nemanja-krsman/ChickenCoop_SmartLight/doc/HardwareOverview.md

# Smart Chicken Coop Lighting System — Hardware Overview

This document describes the system architecture, hardware circuits, prototype
components, and installation shown in the project README.

## System Architecture

The following block diagram illustrates the overall system architecture.

System architecture block diagram

The system consists of four primary functional blocks:

- **Real-Time Clock (RTC):** Maintains the time used for scheduled lighting operations, including during power outages when supported by its backup battery.
- **ESP32 Microcontroller:** Executes the scheduling logic, processes zero-cross detection signals, and controls the timing of triac firing pulses.
- **Zero-Cross Detection Circuit:** Provides synchronization signals corresponding to the AC voltage zero crossings, allowing the ESP32 to synchronize its control logic with the mains waveform.
- **Dual-Channel AC Dimmer:** Independently controls the brightness of two connected lighting loads through phase-angle control.

## Hardware Design & Circuit Breakdown

### 1. Zero-Cross Detection Circuit

Zero-cross detection circuit schematic

The zero-cross detection circuit synchronizes the ESP32 with the AC mains waveform.

- **Rectification:** A DF1504S-T bridge rectifier processes the AC input for the detection circuit.
- **Optoisolation:** A 4N25 optocoupler provides electrical isolation between the mains-side detection circuit and the low-voltage control circuitry. Two 120 kΩ resistors connected in parallel limit the current through the optocoupler's input LED.
- **Signal generation:** The optocoupler's output transistor switches according to the detected mains waveform. The ESP32 reads the resulting signal through a GPIO input configured for interrupt-based synchronization.

The firmware uses these synchronization events to determine when to trigger the triacs during each AC half-cycle. The resulting firing delay determines the amount of power delivered to each compatible lighting load.

### 2. Real-Time Clock (RTC) — DS1307

DS1307 real-time clock schematic

The DS1307 RTC maintains the system time independently of the ESP32's reset state.

- **Timekeeping and backup:** A crystal oscillator provides the RTC's time base, while a backup battery (BT1) helps maintain timekeeping when the main supply is unavailable.
- **I²C communication:** The RTC communicates with the ESP32 over the SDA and SCL lines.
- **Voltage considerations:** The DS1307 normally operates from a 5 V supply. The I²C pull-up arrangement must be compatible with both the RTC and the ESP32's 3.3 V GPIOs. The ESP32 must never be exposed to an I²C pull-up voltage that exceeds its GPIO ratings.

### 3. Dual-Channel AC Dimmer Circuit

Dual-channel AC dimmer schematic

The dimmer circuit provides independent brightness control for two AC lighting loads.

- **Triac triggering and optoisolation:** Each channel uses a MOC3021-series optotriac driver and a BTA16-600B power triac. The optotriac driver provides an isolation barrier between the low-voltage control circuitry and the mains-side triac control circuit.
- **Phase-angle control:** After detecting an AC zero crossing, the ESP32 waits for a calculated delay before generating a triac firing pulse. Adjusting this delay changes the portion of each AC half-cycle delivered to the load, allowing the controller to regulate brightness.
- **Transient suppression:** An RC snubber network, consisting of the corresponding resistor and capacitor across each triac, helps limit voltage transients and unwanted rapid voltage changes. Its component values and suitability depend on the load and must be validated for the intended application.

## Prototyping & Installation

A custom PCB is not strictly necessary to experiment with the system's control logic. A prototype can also be assembled using suitable off-the-shelf modules.

### AC Dimmer Module

A compatible RobotDyn AC Light Dimmer Module can be used for prototyping, provided its interface, channel count, load compatibility, and electrical ratings match the application.

AC dimmer module

### RTC Module

A DS1307-based I²C real-time clock module with a backup battery can provide the timekeeping functionality.

RTC module

### Microcontroller

A standard ESP32 development board can be used to run the firmware and handle communication, scheduling, and dimmer synchronization.

## Prototype & Field Installation

The following photos document the prototype testing process and the final installation.

### Figure 1 — Bench Testing

Initial testing of the ESP32, RTC, and AC dimmer module.

Bench testing setup

Prototype electronics setup

### Figure 2 — Field Installation

The final enclosure and wiring installed inside the chicken coop.

Installed controller enclosure

Completed field installation

## Safety Warning

**This project involves hazardous mains voltage (230 V AC).**

Working with mains electricity can cause fatal electric shock, serious injury, fire, or property damage. The circuit diagrams and firmware are provided for educational and engineering reference purposes; they are not a substitute for a verified, compliant electrical design.

- Disconnect the mains supply before assembly, modification, or troubleshooting, and verify that the circuit is de-energized before touching it.
- Maintain appropriate isolation, creepage distances, and clearance distances between mains-voltage and low-voltage circuits.
- Use a suitable enclosure that prevents accidental contact with live components and provides appropriate protection against environmental conditions.
- Ensure that all components, PCB traces, connectors, wiring, and protective devices are correctly rated for the intended voltage, current, load, and operating environment.
- Have the mains-voltage design, installation, and testing reviewed or performed by a qualified person.

**Disclaimer:** This project is provided for educational and informational purposes only. Anyone building, modifying, or using it is responsible for ensuring that the resulting system is safe and complies with applicable electrical safety standards and regulations. The author accepts no responsibility for injury, property damage, or losses resulting from the construction or use of this project.

[Back to the project README](README.md)
