nemanja-krsman/ChickenCoop_SmartLight/doc/Bottom Layer Board (Gerber viewer).png

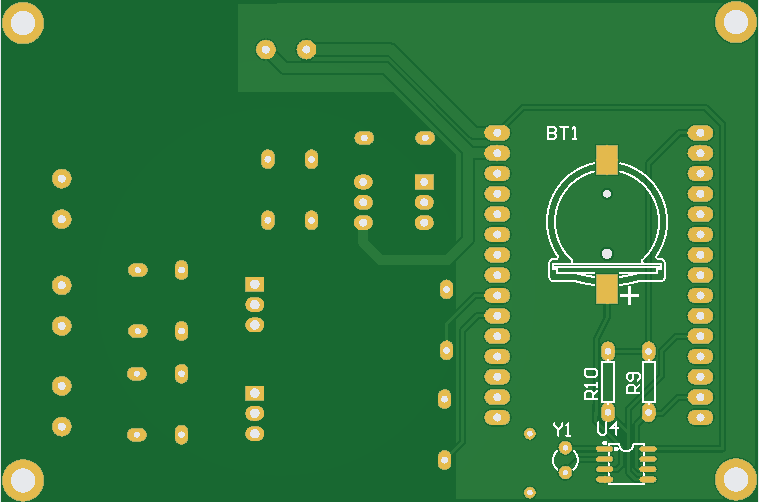
doc/Bottom Layer Board (Gerber viewer).png
