nemanja-krsman/ChickenCoop_SmartLight/doc/Top Layer Board (Gerber viewer).png

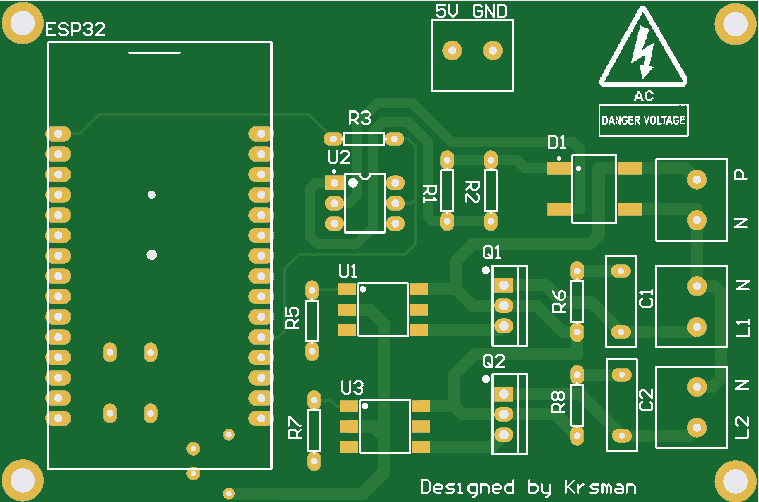
doc/Top Layer Board (Gerber viewer).png
