nemanja-krsman/ChickenCoop_SmartLight/(list of files, drawings)

Other design files:
hardware/CCSL_PCB.PcbDoc
hardware/CCSL_Schematic.SchDoc
hardware/ChickenCoop_SmartLight.PrjPCB
