nemanja-krsman/ChickenCoop_SmartLight/(commit log)

2026-10-18 Added doc, hardware and software folders with initial configuration
    [CCSL_PCB.GBL, CCSL_PCB.GBO, CCSL_PCB.GBP, CCSL_PCB.GBS, CCSL_PCB.GKO, CCSL_PCB.GTL, CCSL_PCB.GTO, CCSL_PCB.GTP]
2026-10-18 Hardware updated
    [CCSL_PCB.GBL, CCSL_PCB.GBO, CCSL_PCB.GBP, CCSL_PCB.GBS, CCSL_PCB.GKO, CCSL_PCB.GTL, CCSL_PCB.GTO, CCSL_PCB.GTP]
2026-10-18 Initialize README with project overview and details
    Added detailed project description, system architecture, and hardware schematic for the Smart Chicken Coop Lighting System.
2026-10-18 Revise README.md for system architecture and hardware details
    Updated system architecture and hardware schematic sections for clarity and added missing details.
2026-10-19 Schematic update
    [CCSL_Schematic.SchDoc]
2026-10-30 Update README with Software Flow reference
    Added reference to visual diagrams for firmware flow.
2026-10-30 Fix link case for Software Flow documentation
    Corrected the case of the 'SoftwareFlow.md' link in the README.
2026-10-30 Fix formatting of Software flow link in README
2026-10-30 Fix link to Software flow in README
    Updated link to Software flow documentation.
